reinerdizonparadis/Mho_Loud/Actual Pictures/bb mostly.jpg

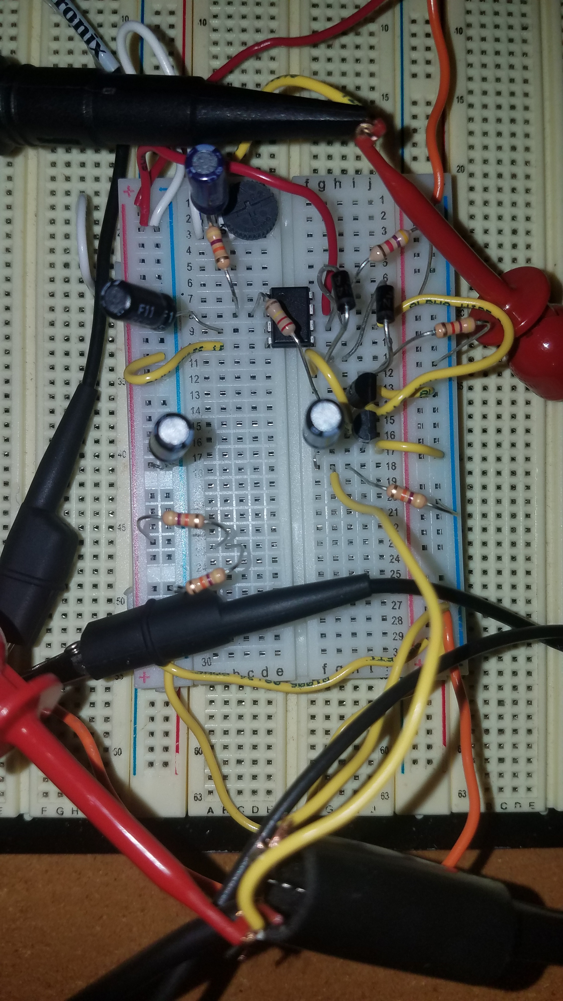
Actual Pictures/bb mostly.jpg
