reinerdizonparadis/Mho_Loud/Actual Pictures/bb no wires.jpg

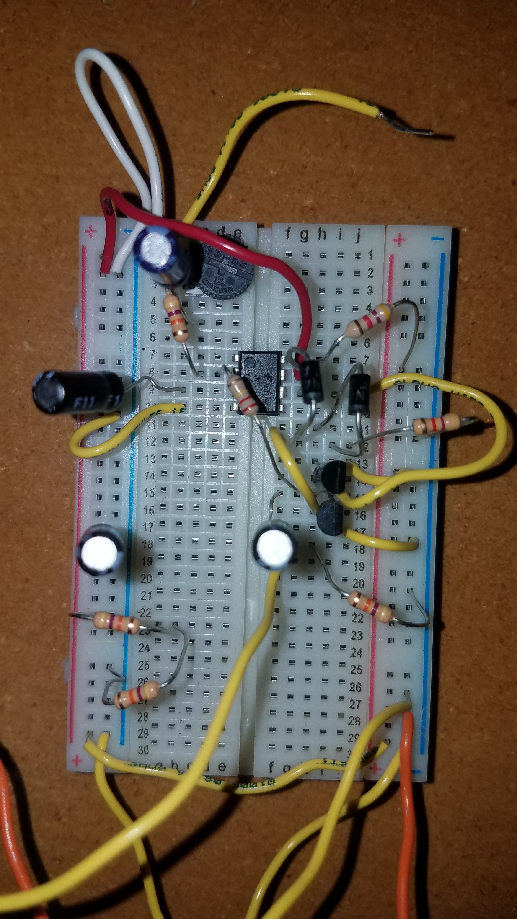
Actual Pictures/bb no wires.jpg
