reinerdizonparadis/Mho_Loud/README.md

# Mho Loud - Engineering Electronics I Laboratory Final Project

UNLV College of Engineering - Department of Electrical & Computer Engineering<br>
**Class**: EE 320L<br>
**Author**: Reiner Dizon<br><br>

Schematic and PCB are included. Refer to Project Report PDF for more details.
