reinerdizonparadis/Mho_Loud/Actual Pictures/bb.jpg

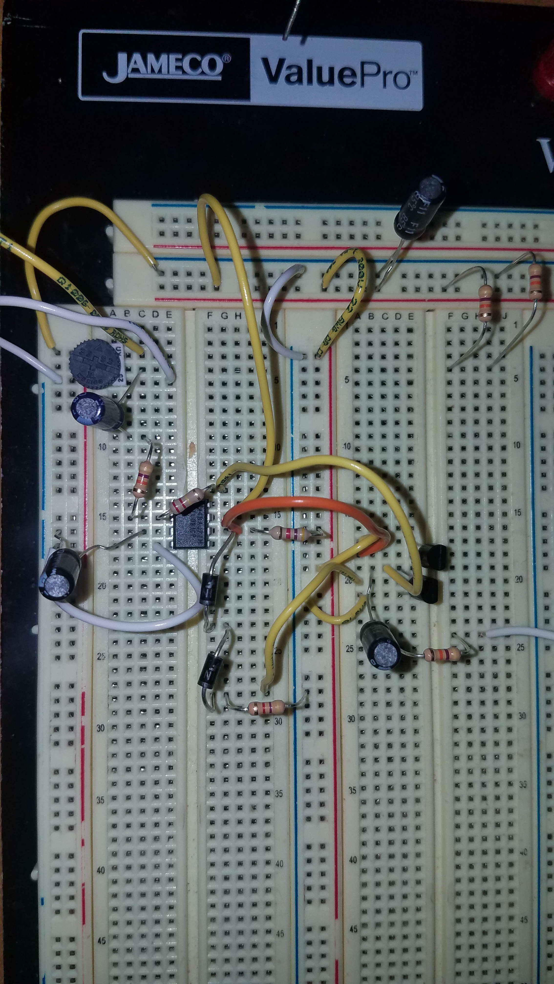
Actual Pictures/bb.jpg
