reinerdizonparadis/Mho_Loud/Actual Pictures/clipping.PNG

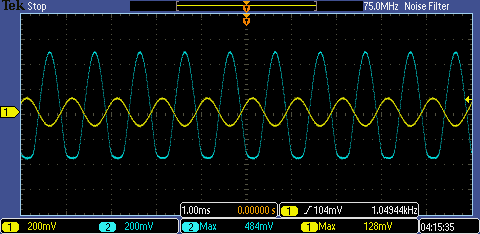
Actual Pictures/clipping.PNG
