reinerdizonparadis/Mho_Loud/Actual Pictures/Corner Lower.PNG

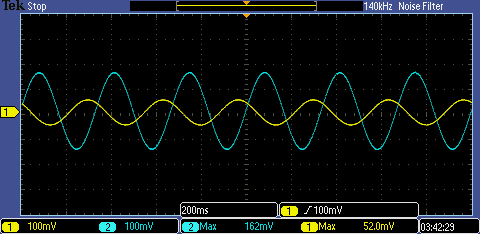
Actual Pictures/Corner Lower.PNG
