reinerdizonparadis/Mho_Loud/Actual Pictures/Corner Upper.PNG

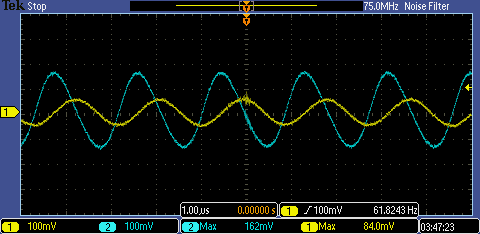
Actual Pictures/Corner Upper.PNG
