reinerdizonparadis/Mho_Loud/Actual Pictures/max.PNG

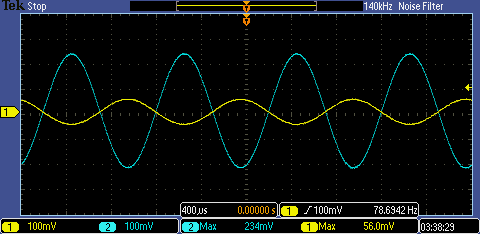
Actual Pictures/max.PNG
