reinerdizonparadis/Mho_Loud/Actual Pictures/min.PNG

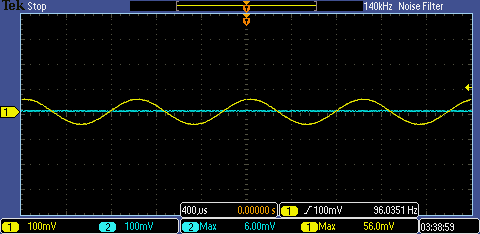
Actual Pictures/min.PNG
