reinerdizonparadis/Mho_Loud/Actual Pictures/opamp out.PNG

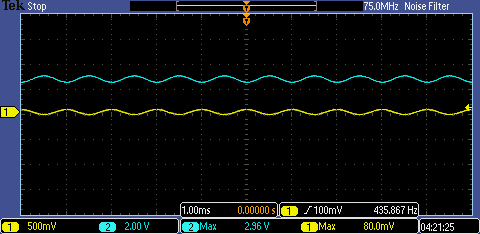
Actual Pictures/opamp out.PNG
