reinerdizonparadis/Mho_Loud/Simulation Pictures/PCB.png

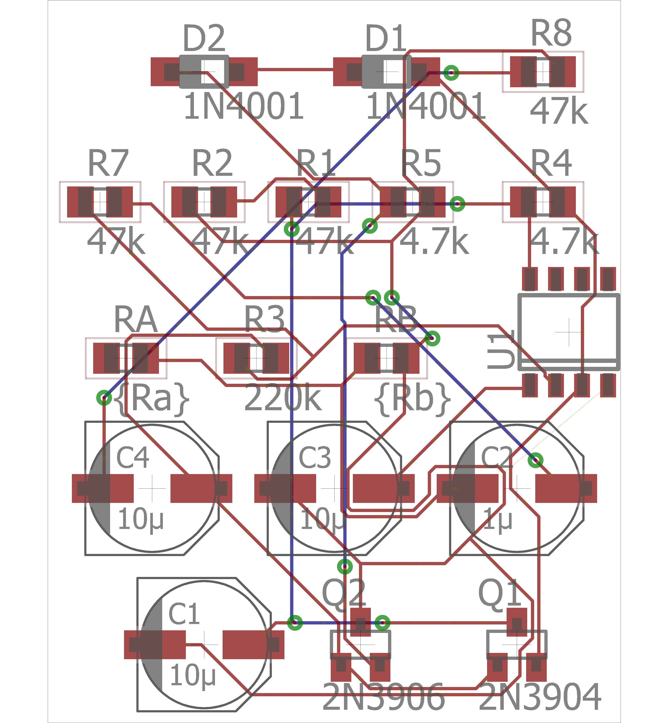
Simulation Pictures/PCB.png
