reinerdizonparadis/Mho_Loud/Simulation Pictures/Schematic.png

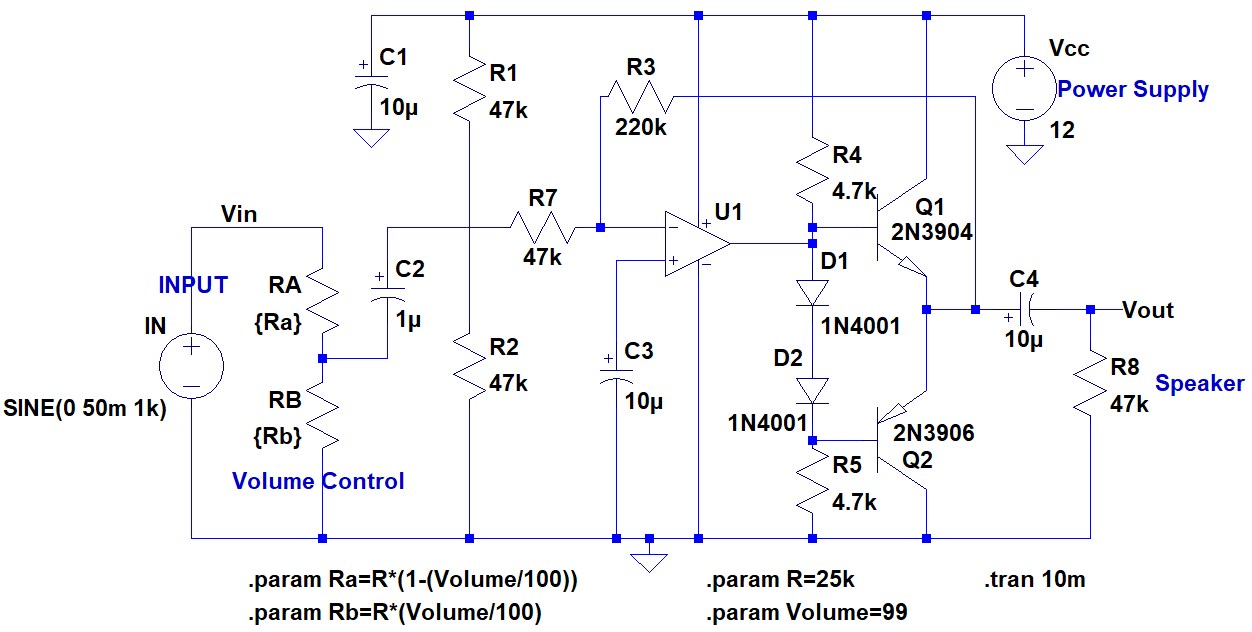
Simulation Pictures/Schematic.png
