reinerdizonparadis/Mho_Loud/Simulation Pictures/Transient - Clipping.png

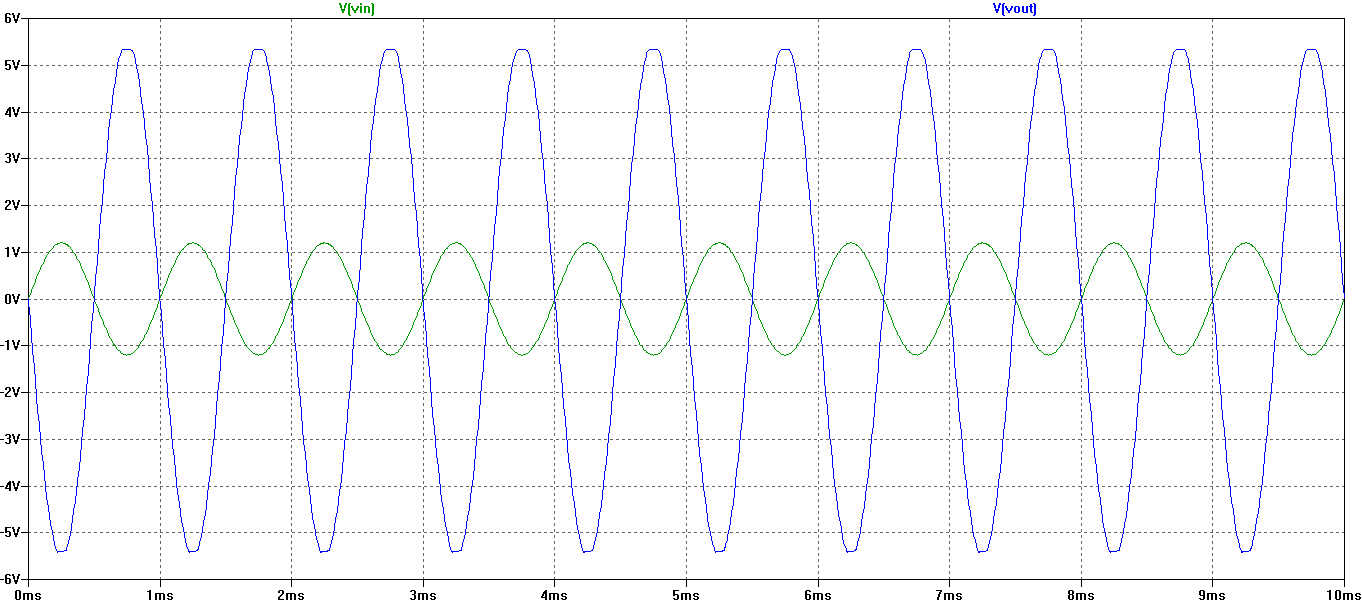
Simulation Pictures/Transient - Clipping.png
