reinerdizonparadis/Mho_Loud/Final Project.asc

C1: polcap; 10µ; V=25
C2: polcap; 1µ; V=10
C3: polcap; 10µ; V=10
C4: polcap; 10µ; V=10
D1: diode; 1N4001
D2: diode; 1N4001
IN: voltage; SINE(0 50m 1k)
Q1: npn; 2N3904
Q2: pnp; 2N3906
R1: res; 47k
R2: res; 47k
R3: res; 220k
R4: res; 4.7k
R5: res; 4.7k
R7: res; 47k
R8: res; 47k
RA: res; {Ra}
RB: res; {Rb}
U1: UniversalOpamp2
Vcc: voltage; 12
Named nets: 0, Vin, Vout
Volume Control
Speaker
Power Supply
.param Rb=R*(Volume/100)
.param Ra=R*(1-(Volume/100))
.tran 10m
.param R=25k
.param Volume=99
INPUT
