reinerdizonparadis/Mho_Loud/PCB/Final Project.brd

## EAGLE design PCB/Final Project.brd (2017-07-05)

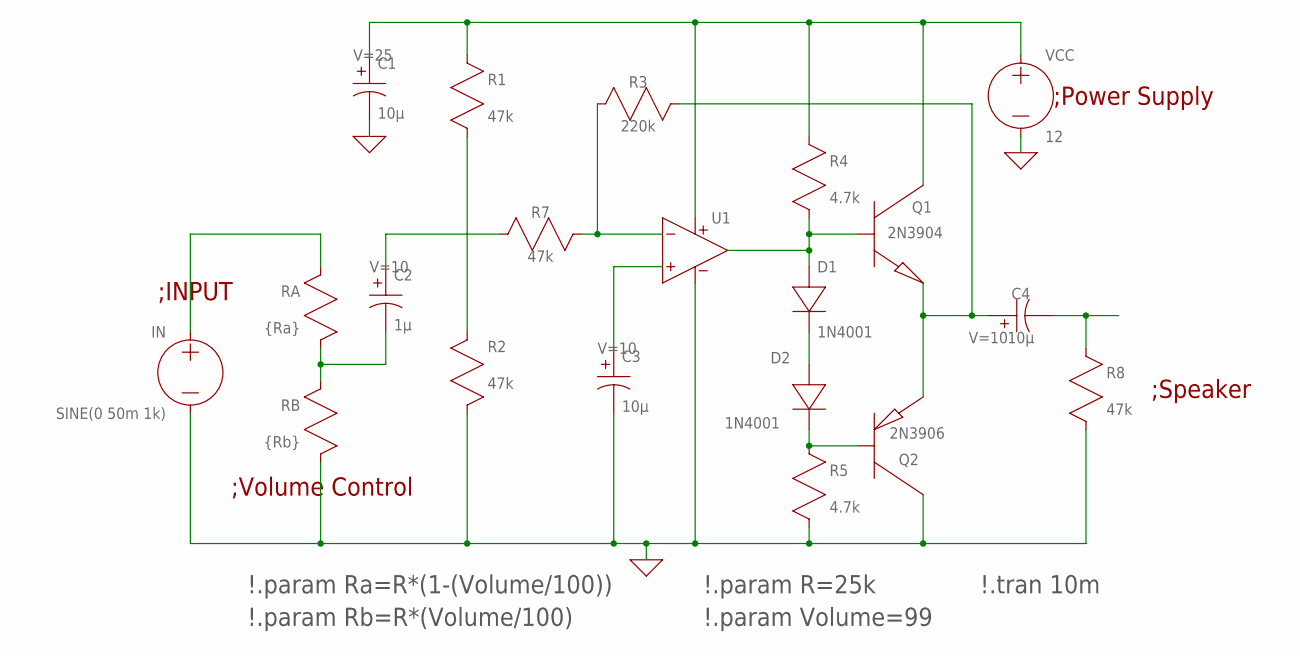
[picture p22: schematic Final Project.sch]

Parts:
C1, C3, C4: 10µ; PANASONIC_D
C2: 1µ; PANASONIC_D
D1, D2: 1N4001; SOD123
Q1: 2N3904; SOT23
Q2: 2N3906; SOT23
R1, R2, R7, R8: 47k; R0805
R3: 220k; R0805
R4, R5: 4.7k; R0805
RA: {Ra}; R0805
RB: {Rb}; R0805
U1: UNIVERSALOPAMP2; S8

Connections:
0: C1.- (B), C3.- (B), Q2.3 (C), R2.1 (A), R5.2 (B), R8.2 (B), RB.2 (B), U1.4 (V-)
unnamed: C1.+ (A), Q1.3 (C), R1.1 (A), R4.1 (A), U1.8 (V+)
unnamed: C4.+ (A), Q1.1 (E), Q2.1 (E), R3.2 (B)
unnamed: C2.+ (A), R7.2 (B)
unnamed: R3.1 (A), R7.1 (A), U1.2 (IN-)
unnamed: D1.A (+), Q1.2 (B), R4.2 (B), U1.3 (OUT)
unnamed: C3.+ (A), U1.1 (IN+)
unnamed: C4.- (B), R8.1 (A)
unnamed: R1.2 (B), R2.2 (B)
unnamed: C2.- (B), RA.2 (B), RB.1 (A)
unnamed: D1.C (-), D2.A (+)
unnamed: D2.C (-), Q2.2 (B), R5.1 (A)

Notes on the sheet:
;Volume Control
;Speaker
;Power Supply
\!.param Rb=R*(Volume/100)
\!.param Ra=R*(1-(Volume/100))
\!.tran 10m
\!.param R=25k
\!.param Volume=99
;INPUT

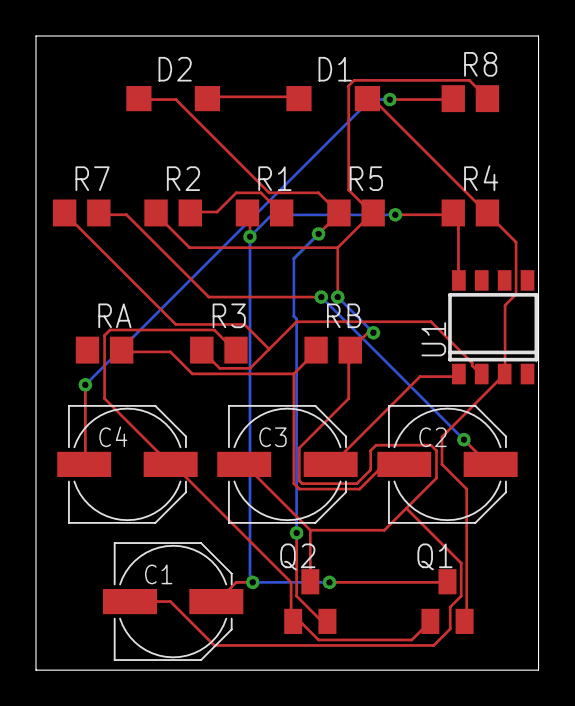
[picture p23: board Final Project.brd from above]

Board: 2 copper layers, 27.9 x 35.2 mm, 18 parts (0 on the bottom side), 12 nets.
